PM04290/B-guard/README.md

# B-guard
Surveillance et sécurité des ruchers
