PM04290/B-guard/(commit log)

2025-08-07 Version Alpha
    Version initiale pour prototype
2025-08-08 fix upload firmware for ESP32-S3
    [BG-S1-securite.ino]
2026-03-12 release 1.2
    fix VBAT pin 33 to pin 15
    [BG-S1-securite.ino, config.h]
